alepnm/rs485_repeater/repeater.pdf

## RS-485 kartotuvas RPT(-O)

Kartotuvas skirtas fiziškai prailginti Modbus ryšio protokolą naudojanti simetrinė ryšio liniją arba prijungti prie esamo ryšio segmento papildomus segmentus. Prie vieno kartotuvo išejimo gaima prijungti iki 32 įrenginiu
su standartiniu RS-485 interfeisu. Maksimalus ryšio linijos ilgis ir jos tipas atitinka RS-485 standartui.
Kiekvieno įrenginio apsauginio poslinkio varžos (pull-up ir pull-down varžos) turi būti atjungtos. Taip pat reikia atjungti ir apkrovimo varžos (terminatorius). Reikia palikti tik tuos terminatorius, kurių įrenginiai yra fiziškai labiausiai nutolęs nuo kartotuvo ir randasi skirtingose linijos segmentose.
POWER įejimas nėra galvaniškai izoliuotas nuo SIDE A segmento, todėl gali būti prijungtas prie šio segmento prijungto įrenginio. Jai kartotuvas yra su optiniu išrešymu (RPT-O), SIDE B segmentas yra galvaniškai izoliuotas nuo SIDE A ir POWER segmentų. Jai kartotuvas be optinio išrešymo funkcijos (RPT), visi jo įejimai/išejimai yra galvaniškai sujungti.

Specifikacija:

1. Maitinimo įtampa: | 12-36VDC/VAC
2. Nominali maitinimo įtampa: | 24VDC
2. Izoliacijos pramušimo įtampa: | 1000VAC
3. Modbus porto greitaveika (baud): | 9600 - 57600
4. Apsaugos klasė | _______
5. Matmenys (mm): | 65 x 65 x 20
6. Svoris (g): | 150

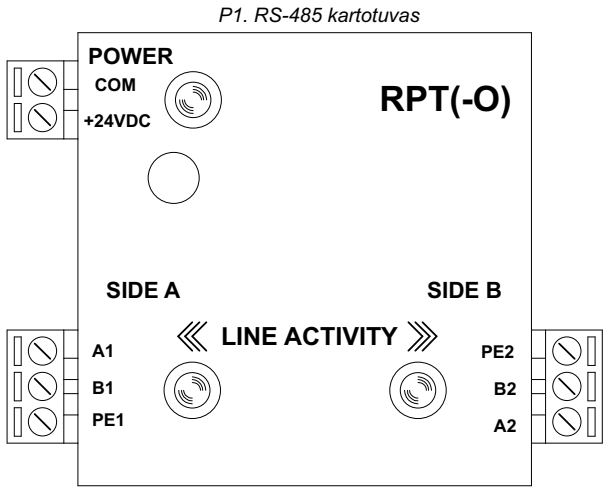
[picture p1: figure]
COM; +24VDC; LINE ACTIVITY; POWER; SIDE A; SIDE B; P1. RS-485 kartotuvas; RPT(-O)
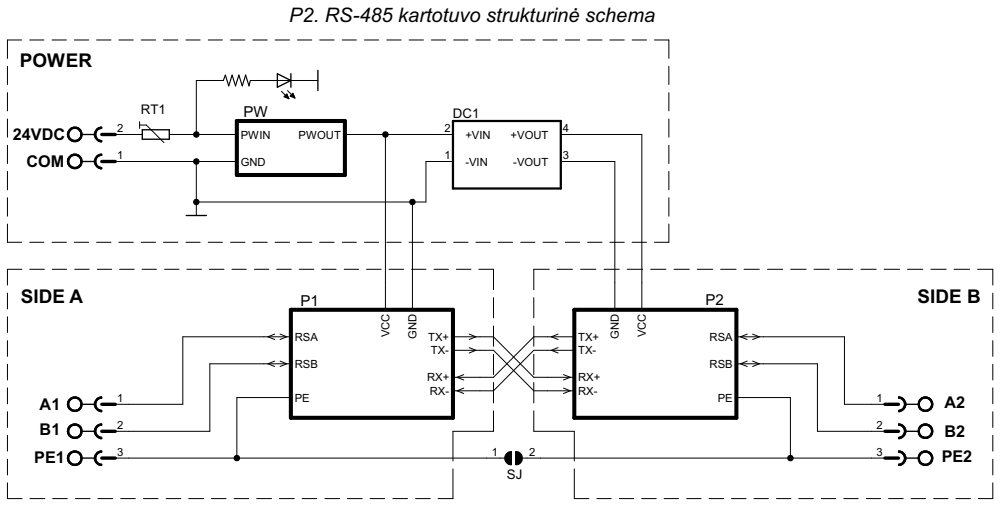
[picture p2: figure]
24VDC; COM; POWER; SIDE A; SIDE B; +VIN 2; -VIN 1; +VOUT; -VOUT; VCC; GND; RSB; RSA; PWIN; PWOUT; P2. RS-485 kartotuvo strukturinė schema
