alepnm/rs485_repeater/gamyba/repeater_opto_bom_pataisyta.ods

Sheet: repeater_opto_bom
 | RS485 kartotuvas RPT-M |  |  | GRG771
Modulis | VentCode |  | Komponentas | Reikšme | Korpusas | Žymėjimas | Kiekis
MAIN | ZKN065 | SMD | Kondensatorius C0805 | 0.1uF | C0805 | P1:C1, P1:C2, P1:C6, P2:C1, P2:C2, P2:C6 | 6
MAIN | ZELRS042 | SMD | Rezistorius R1206 | 120R | R1210 | P1:R1, P2:R1 | 2
MAIN | ZELRS051 | SMD | Rezistorius R0805 | 10kOm | R0805 | P1:R5, P1:R7, P2:R5, P2:R7 | 4
MAIN | ZELRS030 | SMD | Rezistorius R0805 | 10R | R0805 | P1:J1, P1:R17, P1:R18, P2:R17, P2:R18 | 5
MAIN | ZELRS055 | SMD | Rezistorius R0805 | 120R | R0805 | P1:R15, P2:R15 | 2
MAIN | ZELRS053 | SMD | Rezistorius R0805 | 4.7kOm | R0805 | R1, P1:R11, P1:R12, P2:R11, P2:R12, P1:R21, P2:R21 | 7
MAIN | ZELD004 | SMD | Diodas šotky | BAS85 | MINIMELF | P1:D5, P2:D5 | 2
MAIN | ZELM107 | SMD | Mikroschema | 74LVC2G14DBV | SOT23-6 | P1:IC3, P2:IC3 | 2
MAIN | ZELM063 | SMD | Mikroschema | ST485BDR | SO08 | P1:IC5, P2:IC5 | 2
MAIN | ZKN101 | DIP | El. kondensatorius 2.5-6mm | 100x16V | E2,5-6 | P1:C5 | 1
MAIN | ZEL062 | DIP | Saugiklis PTC/X40 | 400mA | X40 | RT1 | 1
MAIN | ZELD007 | DIP | Šviesos diodas 5mm žalios sp. | Power | LED5MM | LED1 | 1
MAIN | ZELD070 | DIP | Šviesos diodas 5mm baltos sp. | LINK | LED5MM | P1:LED1, P2:LED1 | 2
MAIN | ZAJ268 | DIP | Kištukas TBG-5-2P | POWER | MSTBA2 | X1M | 1
MAIN | ZAJ267 | DIP | Kištukas TBG-5-3P | RS1, RS2 | MSTBA3 | X2M, X3M | 2
PWR | ZELD003 | SMD | Diodas | BAS32 | MINIMELF | PW:D1 | 1
PWR | ZKN080 | SMD | Kondensatorius C0805 | 10nF | C0805 | PW:C2 | 1
PWR | ZKN087 | SMD | Kondensatorius C0805 | 470pF | C0805 | PW:C4 | 1
PWR | ZKN062 | SMD | Kondensatorius C1206 | 1uF | C1206 | PW:C3 | 1
PWR | ZKN095 | DIP | El. kondensatorius 2.5-6mm | 47x50V | E2,5-6 | PW:C1 | 1
PWR | ZELRS019 | SMD | Rezistorius R1206 | 1R | R1206 | PW:R4 | 1
PWR | ZELRS053 | SMD | Rezistorius R0805 | 4.7kOm | R0805 | PW:R5 | 1
PWR | ZELRS062 | SMD | Rezistorius R0805 | 12kOm | R0805 | PW:R8 | 1
PWR | ZELRS063 | SMD | Rezistorius R0805 | 2kOm | R0805 | PW:R9 | 1
PWR | ZELI009 | SMD | Droselis | 330uH | DR1030 | PW:L1 | 1
PWR | ZELM041 | SMD | Mikroschema | MC34063AD | SO08 | PW:IC1 | 1
PWR | ZELD046 | SMD | Diodas | 10MQ100 | DO214BA | PW:D5 | 1
DEV | ZAJ263 |  | Jungties lizdas TB-5-2P | POWER |  | X1F | 1
DEV | ZAJ264 |  | Jungties lizdas TB-5-3P | RS1, RS2 |  | X2F, X3F | 2
DEV | ZPA007 |  | Šviesos diodo 5mm žiedas |  |  |  | 3
DEV | ZEL071 |  | PCB plokštė |  |  |  | 1
DEV | ZDE035 |  | Dežutė |  |  |  | 1
 | RS485 kartotuvas RPT-O |  |  | GRG732
Modulis | VentCode |  | Komponentas | Reikšme | Korpusas | Žymėjimas | Kiekis
MAIN | ZKN065 | SMD | Kondensatorius C0805 | 0.1uF | C0805 | P1:C1, P1:C2, P1:C6, P2:C1, P2:C2, P2:C6 | 6
MAIN | ZELRS042 | SMD | Rezistorius R1206 | 120R | R1210 | P1:R1, P2:R1 | 2
MAIN | ZELRS051 | SMD | Rezistorius R0805 | 10kOm | R0805 | P1:R5, P1:R7, P2:R5, P2:R7 | 4
MAIN | ZELRS030 | SMD | Rezistorius R0805 | 10R | R0805 | P1:J1, P1:R17, P1:R18, P2:R17, P2:R18 | 5
MAIN | ZELRS055 | SMD | Rezistorius R0805 | 120R | R0805 | P1:R15, P2:R15 | 2
MAIN | ZELRS053 | SMD | Rezistorius R0805 | 4.7kOm | R0805 | R1, P1:R11, P1:R12, P2:R11, P2:R12, P1:R21, P2:R21 | 7
MAIN | ZELD004 | SMD | Diodas šotky | BAS85 | MINIMELF | P1:D5, P2:D5 | 2
MAIN | ZELM107 | SMD | Mikroschema | 74LVC2G14DBV | SOT23-6 | P1:IC3, P2:IC3 | 2
MAIN | ZELM063 | SMD | Mikroschema | ST485BDR | SO08 | P1:IC5, P2:IC5 | 2
MAIN | ZKN101 | DIP | El. kondensatorius 2.5-6mm | 100x16V | E2,5-6 | P1:C5 | 1
MAIN | ZEL062 | DIP | Saugiklis PTC/X40 | 400mA | X40 | RT1 | 1
MAIN | ZELD007 | DIP | Šviesos diodas 5mm žalios sp. | Power | LED5MM | LED1 | 1
MAIN | ZELD070 | DIP | Šviesos diodas 5mm baltos sp. | LINK | LED5MM | P1:LED1, P2:LED1 | 2
MAIN | ZAJ268 | DIP | Kištukas TBG-5-2P | POWER | MSTBA2 | X1M | 1
MAIN | ZAJ267 | DIP | Kištukas TBG-5-3P | RS1, RS2 | MSTBA3 | X2M, X3M | 2
PWR | ZELD003 | SMD | Diodas | BAS32 | MINIMELF | PW:D1 | 1
PWR | ZKN080 | SMD | Kondensatorius C0805 | 10nF | C0805 | PW:C2 | 1
PWR | ZKN087 | SMD | Kondensatorius C0805 | 470pF | C0805 | PW:C4 | 1
PWR | ZKN062 | SMD | Kondensatorius C1206 | 1uF | C1206 | PW:C3 | 1
PWR | ZKN095 | DIP | El. kondensatorius 2.5-6mm | 47x50V | E2,5-6 | PW:C1 | 1
PWR | ZELRS019 | SMD | Rezistorius R1206 | 1R | R1206 | PW:R4 | 1
PWR | ZELRS053 | SMD | Rezistorius R0805 | 4.7kOm | R0805 | PW:R5 | 1
PWR | ZELRS062 | SMD | Rezistorius R0805 | 12kOm | R0805 | PW:R8 | 1
PWR | ZELRS063 | SMD | Rezistorius R0805 | 2kOm | R0805 | PW:R9 | 1
PWR | ZELI009 | SMD | Droselis | 330uH | DR1030 | PW:L1 | 1
PWR | ZELM041 | SMD | Mikroschema | MC34063AD | SO08 | PW:IC1 | 1
PWR | ZELD046 | SMD | Diodas | 10MQ100 | DO214BA | PW:D5 | 1
OPTO | ZELRS056 | SMD | Rezistorius R0805 | 470R | R0805 | P1:R16, P2:R16 | 2
OPTO | ZELM128 | SMD | Optronas | H11L1SM | DIL6-SMD | P1:OK1, P2:OK1 | 2
OPTO | ZAUR312 | DIP | DC/DC keitiklis CRE1S0505S3C | 5V/5V | NME | DC1 | 1
OPTO | ZKN101 | DIP | El. kondensatorius 2.5-6mm | 100x16V | E2,5-6 | P2:C5 | 1
OPTO | ZELD074 | SMD | TVS diodas | SM712 | SOT23 | P1:TVS1, P2:TVS1 | 2
DEV | ZAJ263 |  | Jungties lizdas TB-5-2P | POWER |  | X1F | 1
DEV | ZAJ264 |  | Jungties lizdas TB-5-3P | RS1, RS2 |  | X2F, X3F | 2
DEV | ZPA007 |  | Šviesos diodo 5mm žiedas |  |  |  | 3
DEV | ZEL071 |  | PCB plokštė |  |  |  | 1
DEV | ZDE035 |  | Dežutė |  |  |  | 1
OPTO | ZELD044 | SMD | TVS diodas | PESD5V0S1BA | SOD323 | P1:D7, P2:D7 | 2

Sheet: peek_and_place
E$1 | TP2 | 12.47 | 122.83 | 0 | REF
E$2 | TP2 | 0.00 | 0.00 | 0 | REF
E$3 | TP2 | 258.08 | 12.59 | 0 | REF
E$4 | TP2 | 270.00 | 136.00 | 0 | REF
P1:C1 | C0805 | 48.53 | 18.69 | 270 | 0.1
P1:C11 | C0805 | 113.81 | 27.83 | 270 | 0.1
P1:C12 | C0805 | 111.27 | 18.69 | 270 | 0.1
P1:C13 | C0805 | 111.65 | 27.83 | 270 | 0.1
P1:C16 | C0805 | 94.00 | 107.59 | 90 | 0.1
P1:C17 | C0805 | 96.54 | 116.73 | 90 | 0.1
P1:C18 | C0805 | 96.16 | 107.59 | 90 | 0.1
P1:C2 | C0805 | 48.91 | 27.83 | 270 | 0.1
P1:C21 | C0805 | 176.55 | 27.83 | 270 | 0.1
P1:C22 | C0805 | 174.01 | 18.69 | 270 | 0.1
P1:C23 | C0805 | 174.39 | 27.83 | 270 | 0.1
P1:C26 | C0805 | 156.74 | 107.59 | 90 | 0.1
P1:C27 | C0805 | 159.28 | 116.73 | 90 | 0.1
P1:C28 | C0805 | 158.90 | 107.59 | 90 | 0.1
P1:C3 | C0805 | 31.26 | 107.59 | 90 | 0.1
P1:C31 | C0805 | 239.29 | 27.83 | 270 | 0.1
P1:C32 | C0805 | 236.75 | 18.69 | 270 | 0.1
P1:C33 | C0805 | 237.13 | 27.83 | 270 | 0.1
P1:C36 | C0805 | 219.48 | 107.59 | 90 | 0.1
P1:C37 | C0805 | 222.02 | 116.73 | 90 | 0.1
P1:C38 | C0805 | 221.63 | 107.59 | 90 | 0.1
P1:C4 | C0805 | 33.80 | 116.73 | 90 | 0.1
P1:C6 | C0805 | 51.07 | 27.83 | 270 | 0.1
P1:C8 | C0805 | 33.42 | 107.59 | 90 | 0.1
P2:C1 | C0805 | 50.95 | 57.17 | 90 | 0.1
P2:C11 | C0805 | 109.87 | 49.17 | 270 | 0.1
P2:C12 | C0805 | 113.68 | 57.17 | 90 | 0.1
P2:C13 | C0805 | 123.97 | 46.88 | 270 | 0.1
P2:C16 | C0805 | 97.94 | 86.25 | 90 | 0.1
P2:C17 | C0805 | 94.13 | 78.25 | 270 | 0.1
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
P2:TVS7 | SOT23 | 250.59 | 62.25 | 0 | SM712
P2:TVS8 | SOT23 | 208.17 | 73.17 | 180 | SM712
P1:D1 | SOD323-R | 25.29 | 113.94 | 180 | PESD1LIN
P1:D11 | SOD323-R | 150.77 | 113.94 | 180 | PESD1LIN
P1:D13 | SOD323-R | 245.26 | 21.48 | 0 | PESD1LIN
P1:D15 | SOD323-R | 213.51 | 113.94 | 180 | PESD1LIN
P1:D3 | SOD323-R | 119.78 | 21.48 | 0 | PESD1LIN
P1:D6 | SOD323-R | 88.03 | 113.94 | 180 | PESD1LIN
P1:D7 | SOD323-R | 57.04 | 21.48 | 0 | PESD1LIN
P1:D9 | SOD323-R | 182.52 | 21.48 | 0 | PESD1LIN
P2:D1 | SOD323-R | 19.96 | 74.44 | 0 | PESD1LIN
P2:D11 | SOD323-R | 145.43 | 74.44 | 0 | PESD1LIN
P2:D13 | SOD323-R | 250.59 | 60.98 | 180 | PESD1LIN
P2:D15 | SOD323-R | 208.17 | 74.44 | 0 | PESD1LIN
P2:D3 | SOD323-R | 125.11 | 60.98 | 180 | PESD1LIN
P2:D6 | SOD323-R | 82.70 | 74.44 | 0 | PESD1LIN
P2:D7 | SOD323-R | 62.38 | 60.98 | 180 | PESD1LIN
P2:D9 | SOD323-R | 187.85 | 60.98 | 180 | PESD1LIN
PW:IC2* | SOT223 | 24.66 | 43.83 | 180 | LM340-DCY
PW:IC2*1 | SOT223 | 57.68 | 91.59 | 0 | LM340-DCY
PW:IC2*2 | SOT223 | 87.40 | 43.83 | 180 | LM340-DCY
PW:IC2*3 | SOT223 | 120.42 | 91.59 | 0 | LM340-DCY
PW:IC2*4 | SOT223 | 150.13 | 43.83 | 180 | LM340-DCY
PW:IC2*5 | SOT223 | 183.15 | 91.59 | 0 | LM340-DCY
PW:IC2*6 | SOT223 | 212.87 | 43.83 | 180 | LM340-DCY
PW:IC2*7 | SOT223 | 245.89 | 91.59 | 0 | LM340-DCY

Sheet: gauti_komponentai
 |  |  |  |  |  | GRG732 x5 |  |  |  | GRG771 x5
Modulis | VentCode |  | Komponentas | Reikšme | Korpusas | Kiekis | Viso | Gauta | Atsiimti | Kiekis | Viso | Gauta | Atsiimti | Viso atsiimti
MAIN | ZAJ267 | DIP | Kištukas TBG-5-3P | RS1, RS2 | MSTBA3 | 2 | 10 | 0 | 10 | 2 | 10 | 0 | 10 | 20
MAIN | ZAJ268 | DIP | Kištukas TBG-5-2P | POWER | MSTBA2 | 1 | 5 | 0 | 5 | 1 | 5 | 0 | 5 | 10
OPTO | ZAUR312 | DIP | DC/DC keitiklis CRE1S0505S3C | 5V/5V | NME | 1 | 5 | 0 | 5 | - | 0 | 0 | 0 | 5
MAIN | ZEL062 | DIP | Saugiklis PTC/X40 | 400mA | X40 | 1 | 5 | 0 | 5 | 1 | 5 | 0 | 5 | 10
PWR | ZELD003 | SMD | Diodas | BAS32 | MINIMELF | 1 | 5 | 0 | 5 | 1 | 5 | 0 | 5 | 10
MAIN | ZELD004 | SMD | Diodas šotky | BAS85 | MINIMELF | 2 | 10 | 0 | 10 | 2 | 10 | 0 | 10 | 20
MAIN | ZELD007 | DIP | Šviesos diodas 5mm žalios sp. | Power | LED5MM | 1 | 5 | 5 | 0 | 1 | 5 | 0 | 5 | 5
PWR | ZELD046 | SMD | Diodas | 10MQ100 | DO214BA | 1 | 5 | 5 | 0 | 1 | 5 | 0 | 5 | 5
MAIN | ZELD070 | DIP | Šviesos diodas 5mm baltos sp. | LINK | LED5MM | 2 | 10 | 0 | 10 | 2 | 10 | 0 | 10 | 20
OPTO | ZELD074 | SMD | TVS diodas | SM712 | SOT23 | 2 | 10 | 0 | 10 | - | 0 | 0 | 0 | 10
PWR | ZELI009 | SMD | Droselis | 330uH | DR1030 | 1 | 5 | 5 | 0 | 1 | 5 | 0 | 5 | 5
PWR | ZELM041 | SMD | Mikroschema | MC34063AD | SO08 | 1 | 5 | 5 | 0 | 1 | 5 | 0 | 5 | 5
MAIN | ZELM063 | SMD | Mikroschema | ST485BDR | SO08 | 2 | 10 | 10 | 0 | 2 | 10 | 0 | 10 | 10
MAIN | ZELM100 | SMD | Mikroschema | 74LVC2G14DBV | SOT23-6 | 2 | 10 | 0 | 10 | 2 | 10 | 0 | 10 | 20
OPTO | ZELM128 | SMD | Optronas | H11L1SM | DIL6-SMD | 2 | 10 | 0 | 10 | - | 0 | 0 | 0 | 10
PWR | ZELRS019 | SMD | Rezistorius R1206 | 1R | R1206 | 1 | 5 | 0 | 5 | 1 | 5 | 0 | 5 | 10
MAIN | ZELRS030 | SMD | Rezistorius R0805 | 10R | R0805 | 5 | 25 | 0 | 25 | 5 | 25 | 0 | 25 | 50
MAIN | ZELRS042 | SMD | Rezistorius R1206 | 120R | R1210 | 2 | 10 | 0 | 10 | 2 | 10 | 0 | 10 | 20
MAIN | ZELRS051 | SMD | Rezistorius R0805 | 10kOm | R0805 | 4 | 20 | 0 | 20 | 4 | 20 | 0 | 20 | 40
MAIN/PWR | ZELRS053 | SMD | Rezistorius R0805 | 4.7kOm | R0805 | 8 | 40 | 0 | 40 | 8 | 40 | 0 | 40 | 80
MAIN | ZELRS055 | SMD | Rezistorius R0805 | 120R | R0805 | 2 | 10 | 0 | 10 | 2 | 10 | 0 | 10 | 20
OPTO | ZELRS056 | SMD | Rezistorius R0805 | 470R | R0805 | 2 | 10 | 0 | 10 | - | 0 | 0 | 0 | 10
PWR | ZELRS062 | SMD | Rezistorius R0805 | 12kOm | R0805 | 1 | 5 | 0 | 5 | 1 | 5 | 0 | 5 | 10
PWR | ZELRS063 | SMD | Rezistorius R0805 | 2kOm | R0805 | 1 | 5 | 0 | 5 | 1 | 5 | 0 | 5 | 10
PWR | ZKN062 | SMD | Kondensatorius C1206 | 1uF | C1206 | 1 | 5 | 0 | 5 | 1 | 5 | 0 | 5 | 10
MAIN | ZKN065 | SMD | Kondensatorius C0805 | 0.1uF | C0805 | 6 | 30 | 0 | 30 | 6 | 30 | 0 | 30 | 60
PWR | ZKN080 | SMD | Kondensatorius C0805 | 10nF | C0805 | 1 | 5 | 0 | 5 | 1 | 5 | 0 | 5 | 10
PWR | ZKN087 | SMD | Kondensatorius C0805 | 470pF | C0805 | 1 | 5 | 0 | 5 | 1 | 5 | 0 | 5 | 10
PWR | ZKN095 | DIP | El. kondensatorius 2.5-6mm | 47x50V | E2,5-6 | 1 | 5 | 0 | 5 | 1 | 5 | 0 | 5 | 10
MAIN/OPTO | ZKN101 | DIP | El. kondensatorius 2.5-6mm | 100x16V | E2,5-6 | 2 | 10 | 10 | 0 | 1 | 5 | 0 | 5 | 5
DEV | ZAJ263 |  | Jungties lizdas TB-5-2P | POWER |  | 1 | 5 | 0 | 5 | 1 | 5 | 0 | 5 | 10
DEV | ZAJ264 |  | Jungties lizdas TB-5-3P | RS1, RS2 |  | 2 | 10 | 0 | 10 | 2 | 10 | 0 | 10 | 20
DEV | ZPA007 |  | Šviesos diodo 5mm žiedas |  |  | 3 | 15 | 5 | 10 | 3 | 15 | 0 | 15 | 25
DEV | ZEL071 |  | PCB plokštė |  |  | 1 | 5 | 5 | 0 | 1 | 5 | 5 | 0 | 0
DEV | ZDE035 |  | Dežutė |  |  | 1 | 5 | 5 | 0 | 1 | 5 | 5 | 0 | 0
