alepnm/rs485_repeater/repeater_opto.brd

## EAGLE design repeater_opto.brd (2018-02-01)

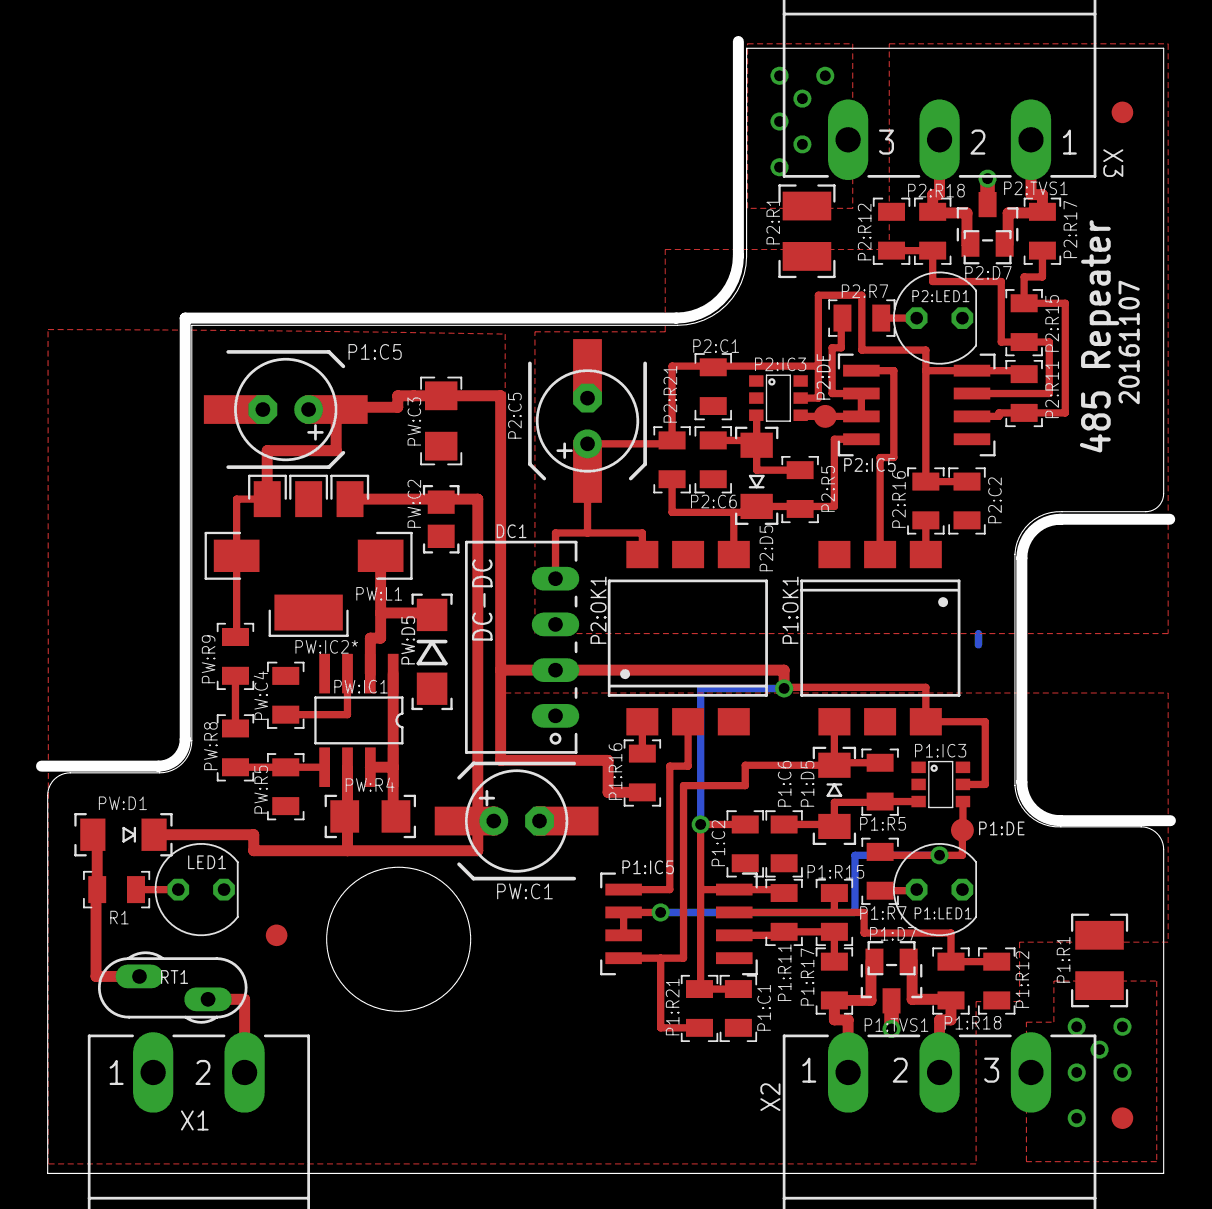
[picture p3: board repeater_opto.brd from above]

Board: 2 copper layers, 62.0 x 62.5 mm, 69 parts (1 on the bottom side), 35 nets.

Parts:
DC1: 5V/5V; NME
LED1: Power; LED5MM
P1:C1, P1:C2, P1:C6, P2:C1, P2:C2, P2:C6: 0.1; C0805
P1:C5, P2:C5: 100x16V; SANYO-OSCON_SMD_C6
P1:C7, P2:C7: 100x16V; E2,5-6
P1:D5, P2:D5: BAS85; MINIMELF
P1:D7, P2:D7: PESD1LIN; SOD323-R
P1:DE, P2:DE: TPB1,27; B1,27
P1:IC3, P2:IC3: 74LVC2G14DBV; SOT23-6
P1:IC5, P2:IC5: MAX485CSA; ESOP-8
P1:LED1, P2:LED1: Link; LED5MM
P1:OK1, P2:OK1: H11L1MS; DIL6-SMD
P1:R1, P2:R1: 100; R1210
P1:R5, P1:R7, P2:R5, P2:R7: 10k; R0805
P1:R11, P1:R12, P2:R11, P2:R12: 4.7k; R0805
P1:R15, P2:R15: 120; R0805
P1:R16, P2:R16: 470; R0805
P1:R17, P1:R18, P2:R17, P2:R18: 10; R0805
P1:R21, P2:R21: 4k7; R0805
P1:TVS1, P2:TVS1: SM712; SOT23
PW:C1: 47x50V; SANYO-OSCON_SMD_C6
PW:C2: 10n; C0805
PW:C3: 1.0; C1206
PW:C4: 470; C0805
PW:C6: 47x50V; E2,5-6
PW:D1: BAS32; MINIMELF
PW:D5: 10MQ100; DO214BA
PW:IC1: MC34063AD; SO08
PW:IC2*: LM340-DCY; SOT223
PW:L1: 330uH; DR1030
PW:R4: 1.0; R1206
PW:R5: 4k7; R0805
PW:R8: 12k; R0805
PW:R9: 2k; R0805
R1: 4k7; R0805
RT1: 400mA; X40
SJ1: SJ
U$2: PLOKSTE_ISPJAUTA
X1: POWER; MSTBA2
X2: SIDE A; MSTBA3
X3: SIDE B; MSTBA3

Connections:
+24V: PW:D1.A, R1.1, RT1.2
GND1: DC1.1, LED1.K, P1:C1.2, P1:C2.2, P1:C5.-, P1:C6.2, P1:C7.-, P1:IC3.2, P1:IC5.5, P1:LED1.K, P1:OK1.5, P1:R1.1, P1:R12.1, PW:C1.-, PW:C2.2, PW:C3.2, PW:C4.2, PW:C6.-, PW:D5.A, PW:IC1.4, PW:IC2*.2, PW:IC2*.4, PW:R5.1, X1.1
GND2: DC1.3, P2:C1.2, P2:C2.2, P2:C5.-, P2:C6.2, P2:C7.-, P2:IC3.2, P2:IC5.5, P2:LED1.K, P2:OK1.5, P2:R1.1, P2:R12.1
unnamed: LED1.A, R1.2
unnamed: RT1.1, X1.2
unnamed: P1:R16.1, P2:OK1.1
unnamed: P1:IC5.1, P2:OK1.2
unnamed: P1:OK1.1, P2:R16.1
unnamed: P1:OK1.2, P2:IC5.1
P1:LED+: P1:DE.PP, P1:IC3.4, P1:IC5.2, P1:IC5.3, P1:R7.2
P1:N$1: P1:LED1.A, P1:R7.1
P1:N$2: P1:IC5.7, P1:R12.2, P1:R15.1, P1:R18.1
P1:N$3: P1:IC5.6, P1:R11.2, P1:R15.2, P1:R17.1
P1:N$7: P1:C6.1, P1:D5.A, P1:IC3.3, P1:R5.2
P1:RX: P1:D5.C, P1:IC5.4, P1:OK1.4, P1:R5.1, P1:R21.1
P2:LED+: P2:DE.PP, P2:IC3.4, P2:IC5.2, P2:IC5.3, P2:R7.2
P2:N$1: P2:LED1.A, P2:R7.1
P2:N$2: P2:IC5.7, P2:R12.2, P2:R15.1, P2:R18.1
P2:N$3: P2:IC5.6, P2:R11.2, P2:R15.2, P2:R17.1
P2:N$7: P2:C6.1, P2:D5.A, P2:IC3.3, P2:R5.2
P2:RX: P2:D5.C, P2:IC5.4, P2:OK1.4, P2:R5.1, P2:R21.1
PE1: P1:R1.2, P1:TVS1.3, SJ1.1, X2.3
PE2: P2:R1.2, P2:TVS1.3, SJ1.2, X3.3
PW:N$2: PW:C1.+, PW:C2.1, PW:C6.+, PW:D1.C, PW:IC1.6, PW:IC2*.1, PW:R4.1
PW:N$29: PW:IC1.1, PW:IC1.7, PW:IC1.8, PW:R4.2
PW:N$30: PW:C4.1, PW:IC1.3
PW:N$33: PW:R8.2, PW:R9.1
PW:N$34: PW:IC1.5, PW:R5.2, PW:R8.1
PW:N$35: PW:D5.C, PW:IC1.2, PW:L1.1
RS1A: P1:D7.C, P1:R17.2, P1:TVS1.2, X2.1
RS1B: P1:D7.A, P1:R18.2, P1:TVS1.1, X2.2
RS2A: P2:D7.C, P2:R17.2, P2:TVS1.2, X3.1
RS2B: P2:D7.A, P2:R18.2, P2:TVS1.1, X3.2
VCC1: DC1.2, P1:C1.1, P1:C2.1, P1:C5.+, P1:C7.+, P1:IC3.5, P1:IC5.8, P1:OK1.6, P1:R11.1, P1:R16.2, P1:R21.2, PW:C3.1, PW:IC2*.3, PW:L1.2, PW:R9.2
VCC2: DC1.4, P2:C1.1, P2:C2.1, P2:C5.+, P2:C7.+, P2:IC3.5, P2:IC5.8, P2:OK1.6, P2:R11.1, P2:R16.2, P2:R21.2
