alepnm/rs485_repeater/gamyba/gerber/gamyba.brd

## EAGLE design gamyba/gerber/gamyba.brd (2018-02-01)

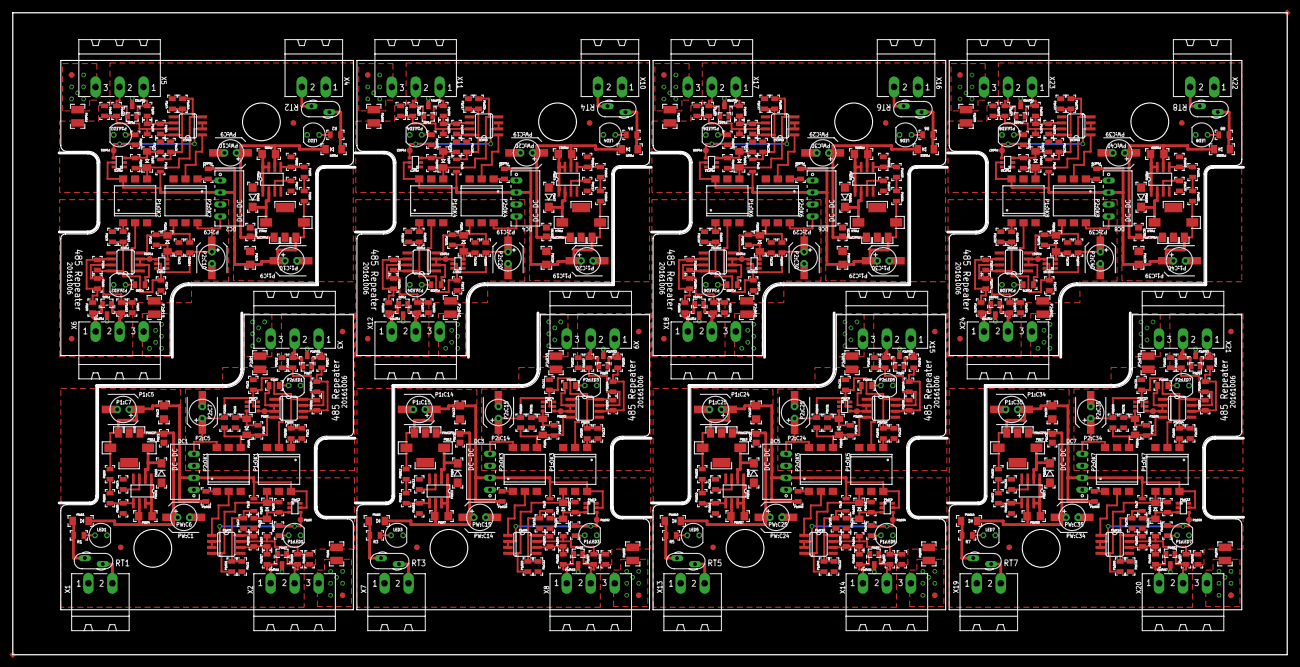
[picture p4: board gamyba.brd from above]

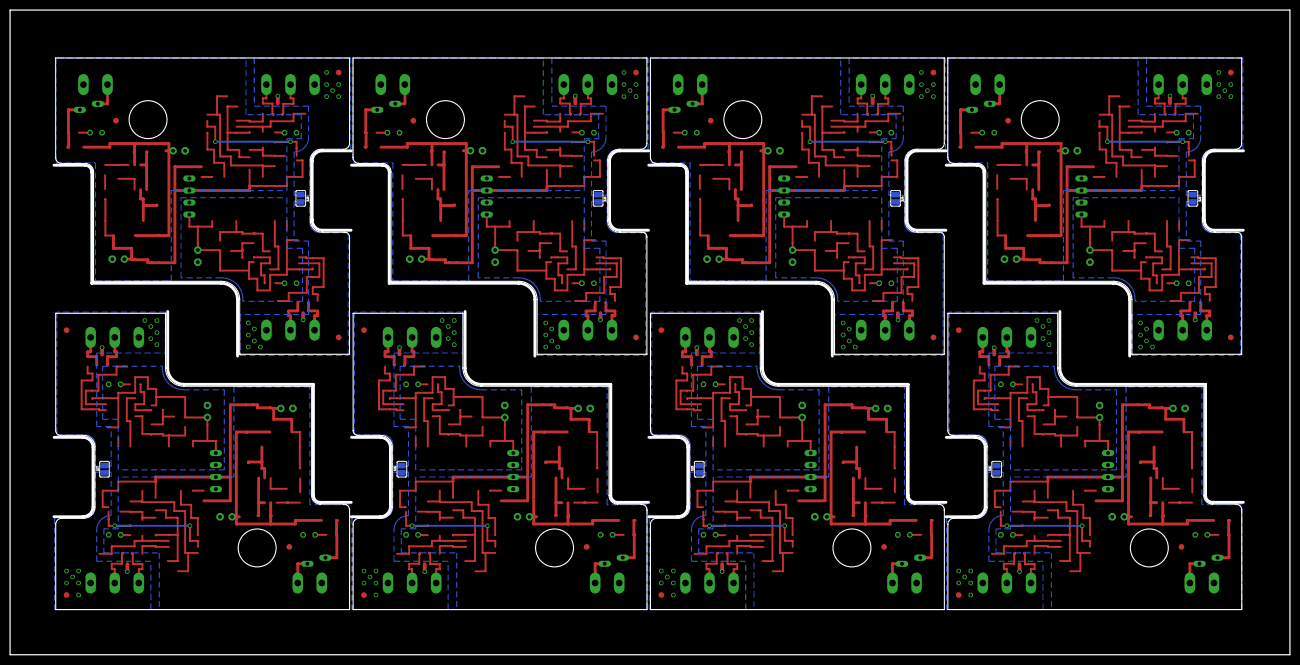
[picture p5: board gamyba.brd from below]

Board: 2 copper layers, 270.0 x 136.0 mm, 564 parts (8 on the bottom side), 280 nets.

Parts:
DC1, DC2, DC3, DC4, DC5, DC6, DC7, DC8: 5V/5V; NME
E$1, E$2, E$3, E$4: REF; TP2
LED1, LED2, LED3, LED4, LED5, LED6, LED7, LED8: Power; LED5MM
P1:C1, P1:C2, P1:C3, P1:C4, P1:C6, P1:C8, P1:C11, P1:C12, P1:C13, P1:C16, P1:C17, P1:C18, P1:C21, P1:C22, P1:C23, P1:C26, P1:C27, P1:C28, P1:C31, P1:C32, P1:C33, P1:C36, P1:C37, P1:C38, P2:C1, P2:C2, P2:C3, P2:C4, P2:C6, P2:C8, P2:C11, P2:C12, P2:C13, P2:C16, P2:C17, P2:C18, P2:C21, P2:C22, P2:C23, P2:C26, P2:C27, P2:C28, P2:C31, P2:C32, P2:C33, P2:C36, P2:C37, P2:C38: 0.1; C0805
P1:C5, P1:C9, P1:C14, P1:C19, P1:C24, P1:C29, P1:C34, P1:C39, P2:C5, P2:C9, P2:C14, P2:C19, P2:C24, P2:C29, P2:C34, P2:C39: 100x10V; SANYO-OSCON_SMD_C6
P1:C7, P1:C10, P1:C15, P1:C20, P1:C25, P1:C30, P1:C35, P1:C40, P2:C7, P2:C10, P2:C15, P2:C20, P2:C25, P2:C30, P2:C35, P2:C40: 100x10V; E2,5-6
P1:D1, P1:D3, P1:D6, P1:D7, P1:D9, P1:D11, P1:D13, P1:D15, P2:D1, P2:D3, P2:D6, P2:D7, P2:D9, P2:D11, P2:D13, P2:D15: PESD1LIN; SOD323-R
P1:D2, P1:D4, P1:D5, P1:D8, P1:D10, P1:D12, P1:D14, P1:D16, P2:D2, P2:D4, P2:D5, P2:D8, P2:D10, P2:D12, P2:D14, P2:D16: BAS85; MINIMELF
P1:DE, P1:DE1, P1:DE2, P1:DE3, P1:DE4, P1:DE5, P1:DE6, P1:DE7, P2:DE, P2:DE1, P2:DE2, P2:DE3, P2:DE4, P2:DE5, P2:DE6, P2:DE7: TPB1,27; B1,27
P1:IC1, P1:IC3, P1:IC4, P1:IC7, P1:IC9, P1:IC11, P1:IC13, P1:IC15, P2:IC1, P2:IC3, P2:IC4, P2:IC7, P2:IC9, P2:IC11, P2:IC13, P2:IC15: 74LVC2G14DBV; SOT23-6
P1:IC2, P1:IC5, P1:IC6, P1:IC8, P1:IC10, P1:IC12, P1:IC14, P1:IC16, P2:IC2, P2:IC5, P2:IC6, P2:IC8, P2:IC10, P2:IC12, P2:IC14, P2:IC16: MAX485CSA; SO08
P1:J1, P1:J2, P1:J3, P1:J4, P1:J5, P1:J6, P1:J7, P1:J8: 0; JUMPER_0805
P1:LED1, P1:LED2, P1:LED3, P1:LED4, P1:LED5, P1:LED6, P1:LED7, P1:LED8, P2:LED1, P2:LED2, P2:LED3, P2:LED4, P2:LED5, P2:LED6, P2:LED7, P2:LED8: Link; LED5MM
P1:OK1, P1:OK2, P1:OK3, P1:OK4, P1:OK5, P1:OK6, P1:OK7, P1:OK8, P2:OK1, P2:OK2, P2:OK3, P2:OK4, P2:OK5, P2:OK6, P2:OK7, P2:OK8: H11L1MS; DIL6-SMD
P1:R1, P1:R19, P1:R30, P1:R40, P1:R50, P1:R60, P1:R70, P1:R80, P2:R1, P2:R19, P2:R30, P2:R40, P2:R50, P2:R60, P2:R70, P2:R80: 101; R1210
P1:R2, P1:R5, P1:R7, P1:R8, P1:R20, P1:R25, P1:R31, P1:R35, P1:R41, P1:R45, P1:R51, P1:R55, P1:R61, P1:R65, P1:R71, P1:R75, P2:R2, P2:R5, P2:R7, P2:R8, P2:R20, P2:R25, P2:R31, P2:R35, P2:R41, P2:R45, P2:R51, P2:R55, P2:R61, P2:R65, P2:R71, P2:R75: 103; R0805
P1:R3, P1:R4, P1:R11, P1:R12, P1:R22, P1:R23, P1:R32, P1:R33, P1:R42, P1:R43, P1:R52, P1:R53, P1:R62, P1:R63, P1:R72, P1:R73, P2:R3, P2:R4, P2:R11, P2:R12, P2:R22, P2:R23, P2:R32, P2:R33, P2:R42, P2:R43, P2:R52, P2:R53, P2:R62, P2:R63, P2:R72, P2:R73: 202; R0805
P1:R6, P1:R15, P1:R24, P1:R34, P1:R44, P1:R54, P1:R64, P1:R74, P2:R6, P2:R15, P2:R24, P2:R34, P2:R44, P2:R54, P2:R64, P2:R74: 121; R0805
P1:R9, P1:R10, P1:R17, P1:R18, P1:R26, P1:R27, P1:R36, P1:R37, P1:R46, P1:R47, P1:R56, P1:R57, P1:R66, P1:R67, P1:R76, P1:R77, P2:R9, P2:R10, P2:R17, P2:R18, P2:R26, P2:R27, P2:R36, P2:R37, P2:R46, P2:R47, P2:R56, P2:R57, P2:R66, P2:R67, P2:R76, P2:R77: 100; R0805
P1:R13, P1:R16, P1:R28, P1:R38, P1:R48, P1:R58, P1:R68, P1:R78, P2:R13, P2:R16, P2:R28, P2:R38, P2:R48, P2:R58, P2:R68, P2:R78: 471; R0805
P1:R14, P1:R21, P1:R29, P1:R39, P1:R49, P1:R59, P1:R69, P1:R79, P2:R14, P2:R21, P2:R29, P2:R39, P2:R49, P2:R59, P2:R69, P2:R79: 472; R0805
P1:TVS1, P1:TVS2, P1:TVS3, P1:TVS4, P1:TVS5, P1:TVS6, P1:TVS7, P1:TVS8, P2:TVS1, P2:TVS2, P2:TVS3, P2:TVS4, P2:TVS5, P2:TVS6, P2:TVS7, P2:TVS8: SM712; SOT23
PW:C1, PW:C9, PW:C14, PW:C19, PW:C24, PW:C29, PW:C34, PW:C39: 47x35V; SANYO-OSCON_SMD_C6
PW:C2, PW:C5, PW:C11, PW:C16, PW:C21, PW:C26, PW:C31, PW:C36: 10n; C0805
PW:C3, PW:C8, PW:C13, PW:C18, PW:C23, PW:C28, PW:C33, PW:C38: 1.0; C1206
PW:C4, PW:C7, PW:C12, PW:C17, PW:C22, PW:C27, PW:C32, PW:C37: 470; C0805
PW:C6, PW:C10, PW:C15, PW:C20, PW:C25, PW:C30, PW:C35, PW:C40: 47x35V; E2,5-6
PW:D1, PW:D3, PW:D6, PW:D8, PW:D10, PW:D12, PW:D14, PW:D16: LL4148; MINIMELF
PW:D2, PW:D4, PW:D5, PW:D7, PW:D9, PW:D11, PW:D13, PW:D15: 10MQ100; DO214BA
PW:IC1, PW:IC2, PW:IC3, PW:IC4, PW:IC5, PW:IC6, PW:IC7, PW:IC8: MC34063AD; SO08
PW:IC2*, PW:IC2*1, PW:IC2*2, PW:IC2*3, PW:IC2*4, PW:IC2*5, PW:IC2*6, PW:IC2*7: LM340-DCY; SOT223
PW:L1, PW:L2, PW:L3, PW:L4, PW:L5, PW:L6, PW:L7, PW:L8: 330uH; DR1030
PW:R1, PW:R4, PW:R7, PW:R13, PW:R17, PW:R21, PW:R25, PW:R29: 1.0; R1206
PW:R2, PW:R5, PW:R10, PW:R14, PW:R18, PW:R22, PW:R26, PW:R30: 472; R0805
PW:R3, PW:R8, PW:R11, PW:R15, PW:R19, PW:R23, PW:R27, PW:R31: 123; R0805
PW:R6, PW:R9, PW:R12, PW:R16, PW:R20, PW:R24, PW:R28, PW:R32: 202; R0805
R1, R2, R3, R4, R5, R6, R7, R8: 472; R0805
RT1, RT2, RT3, RT4, RT5, RT6, RT7, RT8: 100mA; X40
SJ1, SJ2, SJ3, SJ4, SJ5, SJ6, SJ7, SJ8: SJ
U$1, U$2, U$3, U$4, U$5, U$6, U$7, U$8: PLOKSTE_ISPJAUTA
X1, X4, X7, X10, X13, X16, X19, X22: POWER; MSTBA2
X2, X5, X8, X11, X14, X17, X20, X23: RS1; MSTBA3
X3, X6, X9, X12, X15, X18, X21, X24: RS2; MSTBA3

Connections:
+24V: PW:D1.A, R1.1, RT1.2
+24V1: PW:D3.A, R2.1, RT2.2
+24V2: PW:D6.A, R3.1, RT3.2
+24V3: PW:D8.A, R4.1, RT4.2
+24V4: PW:D10.A, R5.1, RT5.2
+24V5: PW:D12.A, R6.1, RT6.2
+24V6: PW:D14.A, R7.1, RT7.2
+24V7: PW:D16.A, R8.1, RT8.2
GND1: DC1.1, LED1.K, P1:C1.2, P1:C2.2, P1:C5.-, P1:C6.2, P1:C7.-, P1:IC3.2, P1:IC5.5, P1:LED1.K, P1:OK1.5, P1:R1.1, P1:R12.1, PW:C1.-, PW:C2.2, PW:C3.2, PW:C4.2, PW:C6.-, PW:D5.A, PW:IC1.4, PW:IC2*.2, PW:IC2*.4, PW:R5.1, X1.1
GND2: DC1.3, P2:C1.2, P2:C2.2, P2:C5.-, P2:C6.2, P2:C7.-, P2:IC3.2, P2:IC5.5, P2:LED1.K, P2:OK1.5, P2:R1.1, P2:R12.1
GND3: DC2.3, P2:C3.2, P2:C4.2, P2:C8.2, P2:C9.-, P2:C10.-, P2:IC1.2, P2:IC2.5, P2:LED2.K, P2:OK2.5, P2:R3.1, P2:R19.1
GND4: DC2.1, LED2.K, P1:C3.2, P1:C4.2, P1:C8.2, P1:C9.-, P1:C10.-, P1:IC1.2, P1:IC2.5, P1:LED2.K, P1:OK2.5, P1:R3.1, P1:R19.1, PW:C5.2, PW:C7.2, PW:C8.2, PW:C9.-, PW:C10.-, PW:D2.A, PW:IC2.4, PW:IC2*1.2, PW:IC2*1.4, PW:R2.1, X4.1
GND5: DC3.3, P2:C11.2, P2:C12.2, P2:C13.2, P2:C14.-, P2:C15.-, P2:IC4.2, P2:IC6.5, P2:LED3.K, P2:OK3.5, P2:R22.1, P2:R30.1
GND6: DC3.1, LED3.K, P1:C11.2, P1:C12.2, P1:C13.2, P1:C14.-, P1:C15.-, P1:IC4.2, P1:IC6.5, P1:LED3.K, P1:OK3.5, P1:R22.1, P1:R30.1, PW:C11.2, PW:C12.2, PW:C13.2, PW:C14.-, PW:C15.-, PW:D4.A, PW:IC2*2.2, PW:IC2*2.4, PW:IC3.4, PW:R10.1, X7.1
GND7: DC4.3, P2:C16.2, P2:C17.2, P2:C18.2, P2:C19.-, P2:C20.-, P2:IC7.2, P2:IC8.5, P2:LED4.K, P2:OK4.5, P2:R32.1, P2:R40.1
GND8: DC4.1, LED4.K, P1:C16.2, P1:C17.2, P1:C18.2, P1:C19.-, P1:C20.-, P1:IC7.2, P1:IC8.5, P1:LED4.K, P1:OK4.5, P1:R32.1, P1:R40.1, PW:C16.2, PW:C17.2, PW:C18.2, PW:C19.-, PW:C20.-, PW:D7.A, PW:IC2*3.2, PW:IC2*3.4, PW:IC4.4, PW:R14.1, X10.1
GND9: DC5.3, P2:C21.2, P2:C22.2, P2:C23.2, P2:C24.-, P2:C25.-, P2:IC9.2, P2:IC10.5, P2:LED5.K, P2:OK5.5, P2:R42.1, P2:R50.1
GND10: DC5.1, LED5.K, P1:C21.2, P1:C22.2, P1:C23.2, P1:C24.-, P1:C25.-, P1:IC9.2, P1:IC10.5, P1:LED5.K, P1:OK5.5, P1:R42.1, P1:R50.1, PW:C21.2, PW:C22.2, PW:C23.2, PW:C24.-, PW:C25.-, PW:D9.A, PW:IC2*4.2, PW:IC2*4.4, PW:IC5.4, PW:R18.1, X13.1
GND11: DC6.3, P2:C26.2, P2:C27.2, P2:C28.2, P2:C29.-, P2:C30.-, P2:IC11.2, P2:IC12.5, P2:LED6.K, P2:OK6.5, P2:R52.1, P2:R60.1
GND12: DC6.1, LED6.K, P1:C26.2, P1:C27.2, P1:C28.2, P1:C29.-, P1:C30.-, P1:IC11.2, P1:IC12.5, P1:LED6.K, P1:OK6.5, P1:R52.1, P1:R60.1, PW:C26.2, PW:C27.2, PW:C28.2, PW:C29.-, PW:C30.-, PW:D11.A, PW:IC2*5.2, PW:IC2*5.4, PW:IC6.4, PW:R22.1, X16.1
GND13: DC7.3, P2:C31.2, P2:C32.2, P2:C33.2, P2:C34.-, P2:C35.-, P2:IC13.2, P2:IC14.5, P2:LED7.K, P2:OK7.5, P2:R62.1, P2:R70.1
GND14: DC7.1, LED7.K, P1:C31.2, P1:C32.2, P1:C33.2, P1:C34.-, P1:C35.-, P1:IC13.2, P1:IC14.5, P1:LED7.K, P1:OK7.5, P1:R62.1, P1:R70.1, PW:C31.2, PW:C32.2, PW:C33.2, PW:C34.-, PW:C35.-, PW:D13.A, PW:IC2*6.2, PW:IC2*6.4, PW:IC7.4, PW:R26.1, X19.1
GND15: DC8.3, P2:C36.2, P2:C37.2, P2:C38.2, P2:C39.-, P2:C40.-, P2:IC15.2, P2:IC16.5, P2:LED8.K, P2:OK8.5, P2:R72.1, P2:R80.1
GND16: DC8.1, LED8.K, P1:C36.2, P1:C37.2, P1:C38.2, P1:C39.-, P1:C40.-, P1:IC15.2, P1:IC16.5, P1:LED8.K, P1:OK8.5, P1:R72.1, P1:R80.1, PW:C36.2, PW:C37.2, PW:C38.2, PW:C39.-, PW:C40.-, PW:D15.A, PW:IC2*7.2, PW:IC2*7.4, PW:IC8.4, PW:R30.1, X22.1
unnamed: LED1.A, R1.2
unnamed: RT1.1, X1.2
unnamed: P1:R13.1, P2:OK2.1
unnamed: P1:OK2.1, P2:R13.1
unnamed: P1:IC2.1, P2:OK2.2
unnamed: P1:OK2.2, P2:IC2.1
unnamed: RT2.1, X4.2
unnamed: LED2.A, R2.2
unnamed: P1:R28.1, P2:OK3.1
unnamed: P1:OK3.1, P2:R28.1
unnamed: P1:IC6.1, P2:OK3.2
unnamed: P1:R16.1, P2:OK1.1
unnamed: P1:IC5.1, P2:OK1.2
unnamed: P1:OK1.1, P2:R16.1
unnamed: P1:OK1.2, P2:IC5.1
unnamed: P1:OK3.2, P2:IC6.1
unnamed: RT3.1, X7.2
unnamed: LED3.A, R3.2
unnamed: P1:R38.1, P2:OK4.1
unnamed: P1:OK4.1, P2:R38.1
unnamed: P1:IC8.1, P2:OK4.2
unnamed: P1:OK4.2, P2:IC8.1
unnamed: RT4.1, X10.2
unnamed: LED4.A, R4.2
unnamed: P1:R48.1, P2:OK5.1
unnamed: P1:OK5.1, P2:R48.1
unnamed: P1:IC10.1, P2:OK5.2
unnamed: P1:OK5.2, P2:IC10.1
unnamed: RT5.1, X13.2
unnamed: LED5.A, R5.2
unnamed: P1:R58.1, P2:OK6.1
unnamed: P1:OK6.1, P2:R58.1
unnamed: P1:IC12.1, P2:OK6.2
unnamed: P1:OK6.2, P2:IC12.1
unnamed: RT6.1, X16.2
unnamed: LED6.A, R6.2
unnamed: P1:R68.1, P2:OK7.1
unnamed: P1:OK7.1, P2:R68.1
unnamed: P1:IC14.1, P2:OK7.2
unnamed: P1:OK7.2, P2:IC14.1
unnamed: RT7.1, X19.2
unnamed: LED7.A, R7.2
unnamed: P1:R78.1, P2:OK8.1
unnamed: P1:OK8.1, P2:R78.1
unnamed: P1:IC16.1, P2:OK8.2
unnamed: P1:OK8.2, P2:IC16.1
unnamed: RT8.1, X22.2
unnamed: LED8.A, R8.2
P1:LED+: P1:DE.PP, P1:IC3.4, P1:IC5.2, P1:IC5.3, P1:R7.2
P1:LED+1: P1:DE1.PP, P1:IC1.4, P1:IC2.2, P1:IC2.3, P1:R8.2
P1:LED+2: P1:DE2.PP, P1:IC4.4, P1:IC6.2, P1:IC6.3, P1:R25.2
P1:LED+3: P1:DE3.PP, P1:IC7.4, P1:IC8.2, P1:IC8.3, P1:R35.2
P1:LED+4: P1:DE4.PP, P1:IC9.4, P1:IC10.2, P1:IC10.3, P1:R45.2
P1:LED+5: P1:DE5.PP, P1:IC11.4, P1:IC12.2, P1:IC12.3, P1:R55.2
P1:LED+6: P1:DE6.PP, P1:IC13.4, P1:IC14.2, P1:IC14.3, P1:R65.2
P1:LED+7: P1:DE7.PP, P1:IC15.4, P1:IC16.2, P1:IC16.3, P1:R75.2
P1:N$1: P1:LED1.A, P1:R7.1
P1:N$2: P1:IC5.7, P1:R12.2, P1:R15.1, P1:R18.1
P1:N$3: P1:IC5.6, P1:R11.2, P1:R15.2, P1:R17.1
P1:N$4: P1:C3.1, P1:D2.A, P1:IC1.3, P1:R2.2
P1:N$5: P1:IC2.7, P1:R3.2, P1:R6.1, P1:R10.1
P1:N$6: P1:IC2.6, P1:R4.2, P1:R6.2, P1:R9.1
P1:N$7: P1:C6.1, P1:D5.A, P1:IC3.3, P1:R5.2
P1:N$8: P1:LED2.A, P1:R8.1
P1:N$9: P1:C11.1, P1:D4.A, P1:IC4.3, P1:R20.2
P1:N$10: P1:IC6.7, P1:R22.2, P1:R24.1, P1:R27.1
P1:N$11: P1:IC6.6, P1:R23.2, P1:R24.2, P1:R26.1
P1:N$12: P1:LED3.A, P1:R25.1
P1:N$13: P1:C16.1, P1:D8.A, P1:IC7.3, P1:R31.2
P1:N$14: P1:IC8.7, P1:R32.2, P1:R34.1, P1:R37.1
P1:N$15: P1:IC8.6, P1:R33.2, P1:R34.2, P1:R36.1
P1:N$16: P1:LED4.A, P1:R35.1
P1:N$17: P1:C21.1, P1:D10.A, P1:IC9.3, P1:R41.2
P1:N$18: P1:IC10.7, P1:R42.2, P1:R44.1, P1:R47.1
P1:N$19: P1:IC10.6, P1:R43.2, P1:R44.2, P1:R46.1
P1:N$20: P1:LED5.A, P1:R45.1
P1:N$21: P1:C26.1, P1:D12.A, P1:IC11.3, P1:R51.2
P1:N$22: P1:IC12.7, P1:R52.2, P1:R54.1, P1:R57.1
P1:N$23: P1:IC12.6, P1:R53.2, P1:R54.2, P1:R56.1
P1:N$24: P1:LED6.A, P1:R55.1
P1:N$25: P1:C31.1, P1:D14.A, P1:IC13.3, P1:R61.2
P1:N$26: P1:IC14.7, P1:R62.2, P1:R64.1, P1:R67.1
P1:N$27: P1:IC14.6, P1:R63.2, P1:R64.2, P1:R66.1
P1:N$28: P1:LED7.A, P1:R65.1
P1:N$29: P1:C36.1, P1:D16.A, P1:IC15.3, P1:R71.2
P1:N$30: P1:IC16.7, P1:R72.2, P1:R74.1, P1:R77.1
P1:N$31: P1:IC16.6, P1:R73.2, P1:R74.2, P1:R76.1
P1:N$32: P1:LED8.A, P1:R75.1
P1:RX: P1:D5.C, P1:IC5.4, P1:OK1.4, P1:R5.1, P1:R21.1
P1:RX1: P1:D2.C, P1:IC2.4, P1:OK2.4, P1:R2.1, P1:R14.1
P1:RX2: P1:D4.C, P1:IC6.4, P1:OK3.4, P1:R20.1, P1:R29.1
P1:RX3: P1:D8.C, P1:IC8.4, P1:OK4.4, P1:R31.1, P1:R39.1
P1:RX4: P1:D10.C, P1:IC10.4, P1:OK5.4, P1:R41.1, P1:R49.1
P1:RX5: P1:D12.C, P1:IC12.4, P1:OK6.4, P1:R51.1, P1:R59.1
P1:RX6: P1:D14.C, P1:IC14.4, P1:OK7.4, P1:R61.1, P1:R69.1
P1:RX7: P1:D16.C, P1:IC16.4, P1:OK8.4, P1:R71.1, P1:R79.1
P2:LED+: P2:DE.PP, P2:IC3.4, P2:IC5.2, P2:IC5.3, P2:R7.2
P2:LED+1: P2:DE1.PP, P2:IC1.4, P2:IC2.2, P2:IC2.3, P2:R8.2
P2:LED+2: P2:DE2.PP, P2:IC4.4, P2:IC6.2, P2:IC6.3, P2:R25.2
P2:LED+3: P2:DE3.PP, P2:IC7.4, P2:IC8.2, P2:IC8.3, P2:R35.2
P2:LED+4: P2:DE4.PP, P2:IC9.4, P2:IC10.2, P2:IC10.3, P2:R45.2
P2:LED+5: P2:DE5.PP, P2:IC11.4, P2:IC12.2, P2:IC12.3, P2:R55.2
P2:LED+6: P2:DE6.PP, P2:IC13.4, P2:IC14.2, P2:IC14.3, P2:R65.2
P2:LED+7: P2:DE7.PP, P2:IC15.4, P2:IC16.2, P2:IC16.3, P2:R75.2
P2:N$1: P2:LED1.A, P2:R7.1
P2:N$2: P2:IC5.7, P2:R12.2, P2:R15.1, P2:R18.1
P2:N$3: P2:IC5.6, P2:R11.2, P2:R15.2, P2:R17.1
P2:N$4: P2:C3.1, P2:D2.A, P2:IC1.3, P2:R2.2
P2:N$5: P2:IC2.7, P2:R3.2, P2:R6.1, P2:R10.1
P2:N$6: P2:IC2.6, P2:R4.2, P2:R6.2, P2:R9.1
P2:N$7: P2:C6.1, P2:D5.A, P2:IC3.3, P2:R5.2
P2:N$8: P2:LED2.A, P2:R8.1
P2:N$9: P2:C11.1, P2:D4.A, P2:IC4.3, P2:R20.2
P2:N$10: P2:IC6.7, P2:R22.2, P2:R24.1, P2:R27.1
P2:N$11: P2:IC6.6, P2:R23.2, P2:R24.2, P2:R26.1
P2:N$12: P2:LED3.A, P2:R25.1
P2:N$13: P2:C16.1, P2:D8.A, P2:IC7.3, P2:R31.2
P2:N$14: P2:IC8.7, P2:R32.2, P2:R34.1, P2:R37.1
P2:N$15: P2:IC8.6, P2:R33.2, P2:R34.2, P2:R36.1
P2:N$16: P2:LED4.A, P2:R35.1
P2:N$17: P2:C21.1, P2:D10.A, P2:IC9.3, P2:R41.2
P2:N$18: P2:IC10.7, P2:R42.2, P2:R44.1, P2:R47.1
P2:N$19: P2:IC10.6, P2:R43.2, P2:R44.2, P2:R46.1
P2:N$20: P2:LED5.A, P2:R45.1
P2:N$21: P2:C26.1, P2:D12.A, P2:IC11.3, P2:R51.2
P2:N$22: P2:IC12.7, P2:R52.2, P2:R54.1, P2:R57.1
P2:N$23: P2:IC12.6, P2:R53.2, P2:R54.2, P2:R56.1
P2:N$24: P2:LED6.A, P2:R55.1
P2:N$25: P2:C31.1, P2:D14.A, P2:IC13.3, P2:R61.2
P2:N$26: P2:IC14.7, P2:R62.2, P2:R64.1, P2:R67.1
P2:N$27: P2:IC14.6, P2:R63.2, P2:R64.2, P2:R66.1
P2:N$28: P2:LED7.A, P2:R65.1
P2:N$29: P2:C36.1, P2:D16.A, P2:IC15.3, P2:R71.2
P2:N$30: P2:IC16.7, P2:R72.2, P2:R74.1, P2:R77.1
P2:N$31: P2:IC16.6, P2:R73.2, P2:R74.2, P2:R76.1
P2:N$32: P2:LED8.A, P2:R75.1
P2:RX: P2:D5.C, P2:IC5.4, P2:OK1.4, P2:R5.1, P2:R21.1
P2:RX1: P2:D2.C, P2:IC2.4, P2:OK2.4, P2:R2.1, P2:R14.1
P2:RX2: P2:D4.C, P2:IC6.4, P2:OK3.4, P2:R20.1, P2:R29.1
P2:RX3: P2:D8.C, P2:IC8.4, P2:OK4.4, P2:R31.1, P2:R39.1
P2:RX4: P2:D10.C, P2:IC10.4, P2:OK5.4, P2:R41.1, P2:R49.1
P2:RX5: P2:D12.C, P2:IC12.4, P2:OK6.4, P2:R51.1, P2:R59.1
P2:RX6: P2:D14.C, P2:IC14.4, P2:OK7.4, P2:R61.1, P2:R69.1
P2:RX7: P2:D16.C, P2:IC16.4, P2:OK8.4, P2:R71.1, P2:R79.1
PE1: P1:R1.2, P1:TVS1.3, SJ1.1, X2.3
PE2: P2:R1.2, P2:TVS1.3, SJ1.2, X3.3
PE3: P1:R19.2, P1:TVS2.3, SJ2.1, X5.3
PE4: P2:R19.2, P2:TVS2.3, SJ2.2, X6.3
PE5: P1:R30.2, P1:TVS3.3, SJ3.1, X8.3
PE6: P2:R30.2, P2:TVS3.3, SJ3.2, X9.3
PE7: P1:R40.2, P1:TVS4.3, SJ4.1, X11.3
PE8: P2:R40.2, P2:TVS4.3, SJ4.2, X12.3
PE9: P1:R50.2, P1:TVS5.3, SJ5.1, X14.3
PE10: P2:R50.2, P2:TVS5.3, SJ5.2, X15.3
PE11: P1:R60.2, P1:TVS6.3, SJ6.1, X17.3
PE12: P2:R60.2, P2:TVS6.3, SJ6.2, X18.3
PE13: P1:R70.2, P1:TVS7.3, SJ7.1, X20.3
PE14: P2:R70.2, P2:TVS7.3, SJ7.2, X21.3
PE15: P1:R80.2, P1:TVS8.3, SJ8.1, X23.3
PE16: P2:R80.2, P2:TVS8.3, SJ8.2, X24.3
PW:N$1: PW:IC2.1, PW:IC2.7, PW:IC2.8, PW:R1.2
PW:N$2: PW:C1.+, PW:C2.1, PW:C6.+, PW:D1.C, PW:IC1.6, PW:IC2*.1, PW:R4.1
PW:N$3: PW:IC2.5, PW:R2.2, PW:R3.1
PW:N$4: PW:C7.1, PW:IC2.3
PW:N$5: PW:D2.C, PW:IC2.2, PW:L2.1
PW:N$6: PW:R3.2, PW:R6.1
PW:N$7: PW:C5.1, PW:C9.+, PW:C10.+, PW:D3.C, PW:IC2.6, PW:IC2*1.1, PW:R1.1
PW:N$8: PW:IC3.1, PW:IC3.7, PW:IC3.8, PW:R7.2
PW:N$9: PW:IC3.5, PW:R10.2, PW:R11.1
PW:N$10: PW:C12.1, PW:IC3.3
PW:N$11: PW:D4.C, PW:IC3.2, PW:L3.1
PW:N$12: PW:R11.2, PW:R12.1
PW:N$13: PW:C11.1, PW:C14.+, PW:C15.+, PW:D6.C, PW:IC2*2.1, PW:IC3.6, PW:R7.1
PW:N$14: PW:IC4.1, PW:IC4.7, PW:IC4.8, PW:R13.2
PW:N$15: PW:IC4.5, PW:R14.2, PW:R15.1
PW:N$16: PW:C17.1, PW:IC4.3
PW:N$17: PW:D7.C, PW:IC4.2, PW:L4.1
PW:N$18: PW:R15.2, PW:R16.1
PW:N$19: PW:C16.1, PW:C19.+, PW:C20.+, PW:D8.C, PW:IC2*3.1, PW:IC4.6, PW:R13.1
PW:N$20: PW:IC5.1, PW:IC5.7, PW:IC5.8, PW:R17.2
PW:N$21: PW:IC5.5, PW:R18.2, PW:R19.1
PW:N$22: PW:C22.1, PW:IC5.3
PW:N$23: PW:D9.C, PW:IC5.2, PW:L5.1
PW:N$24: PW:R19.2, PW:R20.1
PW:N$25: PW:C21.1, PW:C24.+, PW:C25.+, PW:D10.C, PW:IC2*4.1, PW:IC5.6, PW:R17.1
PW:N$26: PW:IC6.1, PW:IC6.7, PW:IC6.8, PW:R21.2
PW:N$27: PW:IC6.5, PW:R22.2, PW:R23.1
PW:N$28: PW:C27.1, PW:IC6.3
PW:N$29: PW:IC1.1, PW:IC1.7, PW:IC1.8, PW:R4.2
PW:N$30: PW:C4.1, PW:IC1.3
PW:N$31: PW:D11.C, PW:IC6.2, PW:L6.1
PW:N$32: PW:R23.2, PW:R24.1
PW:N$33: PW:R8.2, PW:R9.1
PW:N$34: PW:IC1.5, PW:R5.2, PW:R8.1
PW:N$35: PW:D5.C, PW:IC1.2, PW:L1.1
PW:N$36: PW:C26.1, PW:C29.+, PW:C30.+, PW:D12.C, PW:IC2*5.1, PW:IC6.6, PW:R21.1
PW:N$37: PW:IC7.1, PW:IC7.7, PW:IC7.8, PW:R25.2
PW:N$38: PW:IC7.5, PW:R26.2, PW:R27.1
PW:N$39: PW:C32.1, PW:IC7.3
PW:N$40: PW:D13.C, PW:IC7.2, PW:L7.1
PW:N$41: PW:R27.2, PW:R28.1
PW:N$42: PW:C31.1, PW:C34.+, PW:C35.+, PW:D14.C, PW:IC2*6.1, PW:IC7.6, PW:R25.1
PW:N$43: PW:IC8.1, PW:IC8.7, PW:IC8.8, PW:R29.2
PW:N$44: PW:IC8.5, PW:R30.2, PW:R31.1
PW:N$45: PW:C37.1, PW:IC8.3
PW:N$46: PW:D15.C, PW:IC8.2, PW:L8.1
PW:N$47: PW:R31.2, PW:R32.1
PW:N$48: PW:C36.1, PW:C39.+, PW:C40.+, PW:D16.C, PW:IC2*7.1, PW:IC8.6, PW:R29.1
RS1A: P1:D7.C, P1:R17.2, P1:TVS1.2, X2.1
RS1A1: P1:D1.C, P1:R9.2, P1:TVS2.2, X5.1
RS1A2: P1:D3.C, P1:R26.2, P1:TVS3.2, X8.1
RS1A3: P1:D6.C, P1:R36.2, P1:TVS4.2, X11.1
RS1A4: P1:D9.C, P1:R46.2, P1:TVS5.2, X14.1
RS1A5: P1:D11.C, P1:R56.2, P1:TVS6.2, X17.1
RS1A6: P1:D13.C, P1:R66.2, P1:TVS7.2, X20.1
RS1A7: P1:D15.C, P1:R76.2, P1:TVS8.2, X23.1
RS1B: P1:D7.A, P1:R18.2, P1:TVS1.1, X2.2
RS1B1: P1:D1.A, P1:R10.2, P1:TVS2.1, X5.2
RS1B2: P1:D3.A, P1:R27.2, P1:TVS3.1, X8.2
RS1B3: P1:D6.A, P1:R37.2, P1:TVS4.1, X11.2
RS1B4: P1:D9.A, P1:R47.2, P1:TVS5.1, X14.2
RS1B5: P1:D11.A, P1:R57.2, P1:TVS6.1, X17.2
RS1B6: P1:D13.A, P1:R67.2, P1:TVS7.1, X20.2
RS1B7: P1:D15.A, P1:R77.2, P1:TVS8.1, X23.2
RS2A: P2:D7.C, P2:R17.2, P2:TVS1.2, X3.1
RS2A1: P2:D1.C, P2:R9.2, P2:TVS2.2, X6.1
RS2A2: P2:D3.C, P2:R26.2, P2:TVS3.2, X9.1
RS2A3: P2:D6.C, P2:R36.2, P2:TVS4.2, X12.1
RS2A4: P2:D9.C, P2:R46.2, P2:TVS5.2, X15.1
RS2A5: P2:D11.C, P2:R56.2, P2:TVS6.2, X18.1
RS2A6: P2:D13.C, P2:R66.2, P2:TVS7.2, X21.1
RS2A7: P2:D15.C, P2:R76.2, P2:TVS8.2, X24.1
RS2B: P2:D7.A, P2:R18.2, P2:TVS1.1, X3.2
RS2B1: P2:D1.A, P2:R10.2, P2:TVS2.1, X6.2
RS2B2: P2:D3.A, P2:R27.2, P2:TVS3.1, X9.2
RS2B3: P2:D6.A, P2:R37.2, P2:TVS4.1, X12.2
RS2B4: P2:D9.A, P2:R47.2, P2:TVS5.1, X15.2
RS2B5: P2:D11.A, P2:R57.2, P2:TVS6.1, X18.2
RS2B6: P2:D13.A, P2:R67.2, P2:TVS7.1, X21.2
RS2B7: P2:D15.A, P2:R77.2, P2:TVS8.1, X24.2
VCC1: DC1.2, P1:C1.1, P1:C2.1, P1:C5.+, P1:C7.+, P1:IC3.5, P1:IC5.8, P1:J2.1, P1:J2.2, P1:OK1.6, P1:R11.1, P1:R16.2, P1:R21.2, PW:C3.1, PW:IC2*.3, PW:L1.2, PW:R9.2
VCC2: DC1.4, P2:C1.1, P2:C2.1, P2:C5.+, P2:C7.+, P2:IC3.5, P2:IC5.8, P2:OK1.6, P2:R11.1, P2:R16.2, P2:R21.2
VCC3: DC2.2, P1:C4.1, P1:C8.1, P1:C9.+, P1:C10.+, P1:IC1.5, P1:IC2.8, P1:J1.1, P1:J1.2, P1:OK2.6, P1:R4.1, P1:R13.2, P1:R14.2, PW:C8.1, PW:IC2*1.3, PW:L2.2, PW:R6.2
VCC4: DC2.4, P2:C4.1, P2:C8.1, P2:C9.+, P2:C10.+, P2:IC1.5, P2:IC2.8, P2:OK2.6, P2:R4.1, P2:R13.2, P2:R14.2
VCC5: DC3.2, P1:C12.1, P1:C13.1, P1:C14.+, P1:C15.+, P1:IC4.5, P1:IC6.8, P1:J3.1, P1:J3.2, P1:OK3.6, P1:R23.1, P1:R28.2, P1:R29.2, PW:C13.1, PW:IC2*2.3, PW:L3.2, PW:R12.2
VCC6: DC3.4, P2:C12.1, P2:C13.1, P2:C14.+, P2:C15.+, P2:IC4.5, P2:IC6.8, P2:OK3.6, P2:R23.1, P2:R28.2, P2:R29.2
VCC7: DC4.2, P1:C17.1, P1:C18.1, P1:C19.+, P1:C20.+, P1:IC7.5, P1:IC8.8, P1:J4.1, P1:J4.2, P1:OK4.6, P1:R33.1, P1:R38.2, P1:R39.2, PW:C18.1, PW:IC2*3.3, PW:L4.2, PW:R16.2
VCC8: DC4.4, P2:C17.1, P2:C18.1, P2:C19.+, P2:C20.+, P2:IC7.5, P2:IC8.8, P2:OK4.6, P2:R33.1, P2:R38.2, P2:R39.2
VCC9: DC5.2, P1:C22.1, P1:C23.1, P1:C24.+, P1:C25.+, P1:IC9.5, P1:IC10.8, P1:J5.1, P1:J5.2, P1:OK5.6, P1:R43.1, P1:R48.2, P1:R49.2, PW:C23.1, PW:IC2*4.3, PW:L5.2, PW:R20.2
VCC10: DC5.4, P2:C22.1, P2:C23.1, P2:C24.+, P2:C25.+, P2:IC9.5, P2:IC10.8, P2:OK5.6, P2:R43.1, P2:R48.2, P2:R49.2
VCC11: DC6.2, P1:C27.1, P1:C28.1, P1:C29.+, P1:C30.+, P1:IC11.5, P1:IC12.8, P1:J6.1, P1:J6.2, P1:OK6.6, P1:R53.1, P1:R58.2, P1:R59.2, PW:C28.1, PW:IC2*5.3, PW:L6.2, PW:R24.2
VCC12: DC6.4, P2:C27.1, P2:C28.1, P2:C29.+, P2:C30.+, P2:IC11.5, P2:IC12.8, P2:OK6.6, P2:R53.1, P2:R58.2, P2:R59.2
VCC13: DC7.2, P1:C32.1, P1:C33.1, P1:C34.+, P1:C35.+, P1:IC13.5, P1:IC14.8, P1:J7.1, P1:J7.2, P1:OK7.6, P1:R63.1, P1:R68.2, P1:R69.2, PW:C33.1, PW:IC2*6.3, PW:L7.2, PW:R28.2
VCC14: DC7.4, P2:C32.1, P2:C33.1, P2:C34.+, P2:C35.+, P2:IC13.5, P2:IC14.8, P2:OK7.6, P2:R63.1, P2:R68.2, P2:R69.2
VCC15: DC8.2, P1:C37.1, P1:C38.1, P1:C39.+, P1:C40.+, P1:IC15.5, P1:IC16.8, P1:J8.1, P1:J8.2, P1:OK8.6, P1:R73.1, P1:R78.2, P1:R79.2, PW:C38.1, PW:IC2*7.3, PW:L8.2, PW:R32.2
VCC16: DC8.4, P2:C37.1, P2:C38.1, P2:C39.+, P2:C40.+, P2:IC15.5, P2:IC16.8, P2:OK8.6, P2:R73.1, P2:R78.2, P2:R79.2
